bernhardkelm/punkt-strich/docs/animations/attention.png

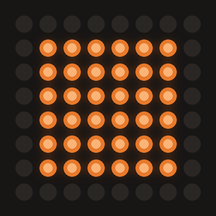
docs/animations/attention.png
