bernhardkelm/punkt-strich/docs/animations/compacting.png

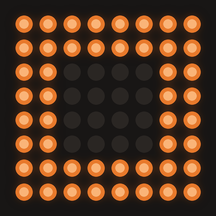
docs/animations/compacting.png
