bernhardkelm/punkt-strich/docs/animations/glitch.png

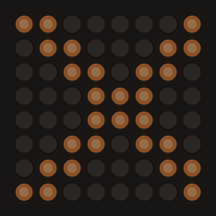
docs/animations/glitch.png
