bernhardkelm/punkt-strich/docs/animations/knight.png

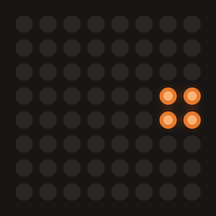
docs/animations/knight.png
