bernhardkelm/punkt-strich/docs/animations/life.png

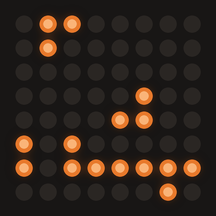
docs/animations/life.png
