bernhardkelm/punkt-strich/docs/animations/limit.png

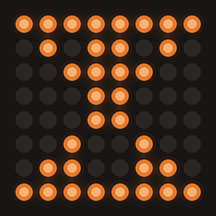
docs/animations/limit.png
