bernhardkelm/punkt-strich/docs/animations/loading.png

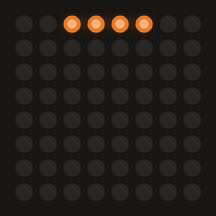
docs/animations/loading.png
