bernhardkelm/punkt-strich/docs/animations/pipes.png

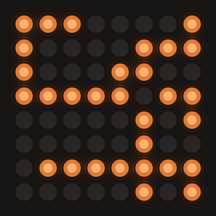
docs/animations/pipes.png
