bernhardkelm/punkt-strich/docs/animations/pong.png

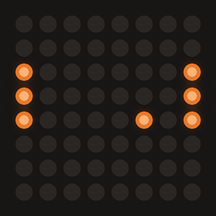
docs/animations/pong.png
