bernhardkelm/punkt-strich/docs/animations/rain.png

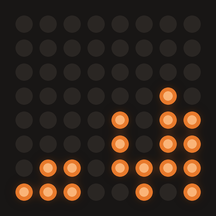
docs/animations/rain.png
