bernhardkelm/punkt-strich/docs/animations/scan.png

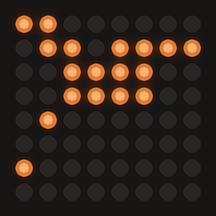
docs/animations/scan.png
