bernhardkelm/punkt-strich/docs/animations/terminal.png

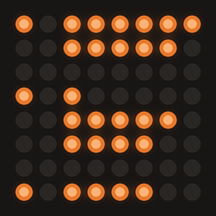
docs/animations/terminal.png
