bernhardkelm/punkt-strich/docs/blueprint/social-preview.png

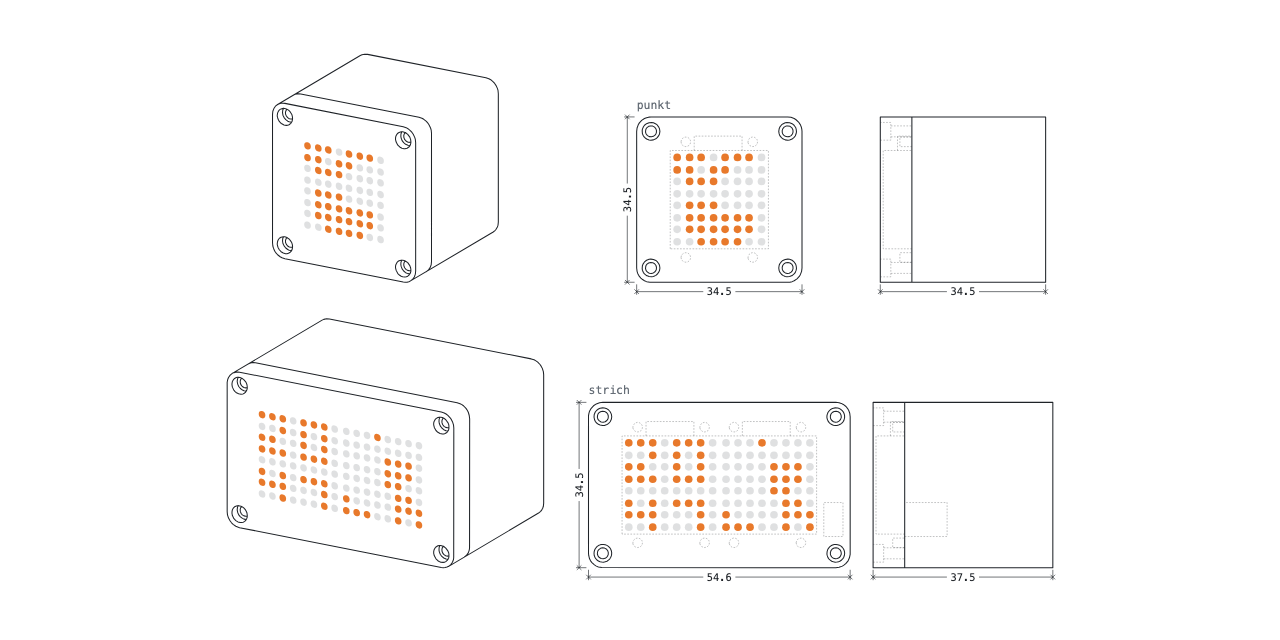
docs/blueprint/social-preview.png
