bernhardkelm/punkt-strich/hardware/punkt_case.3mf

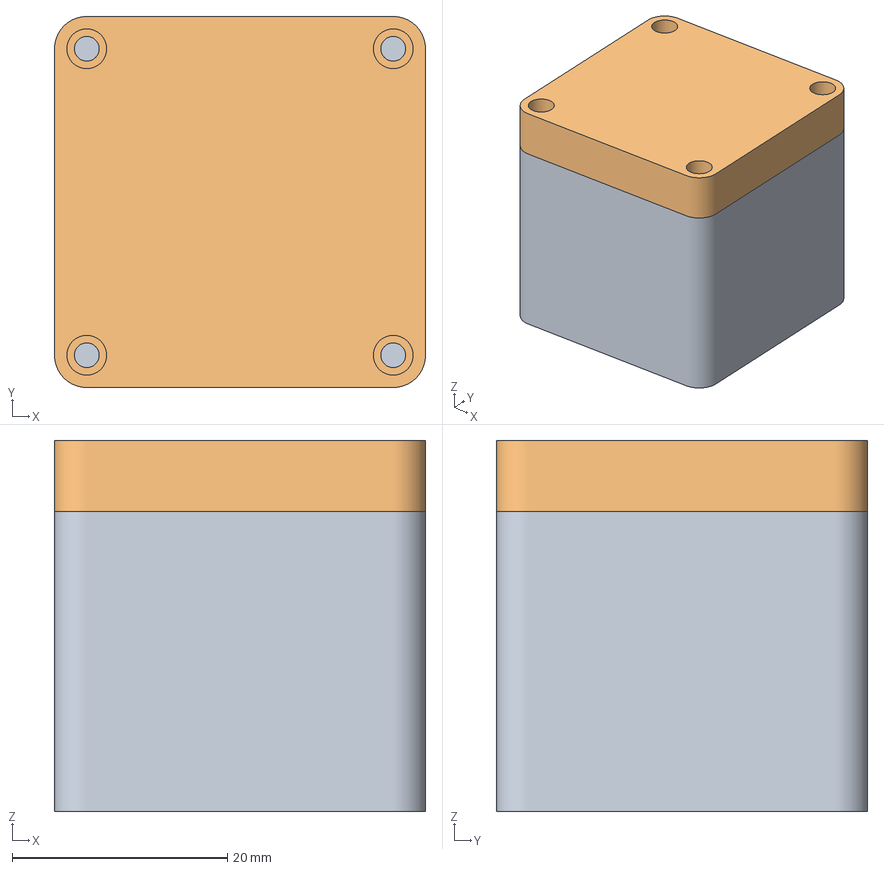
[picture p55: CAD file, 2026-10-19]
hardware/punkt_case.3mf
34.5 x 34.5 x 34.5 mm
Case
Screen
