bernhardkelm/punkt-strich/hardware/strich_case.3mf

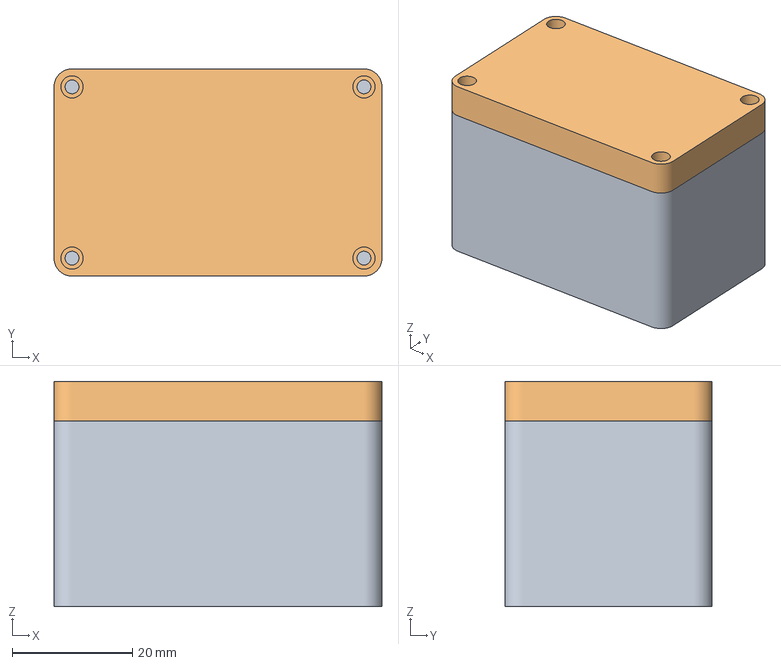
[picture p56: CAD file, 2026-10-19]
hardware/strich_case.3mf
54.6 x 34.5 x 37.5 mm
Strich case
Strich screen
