bernhardkelm/punkt-strich/hardware/esp_solder_jig.3mf

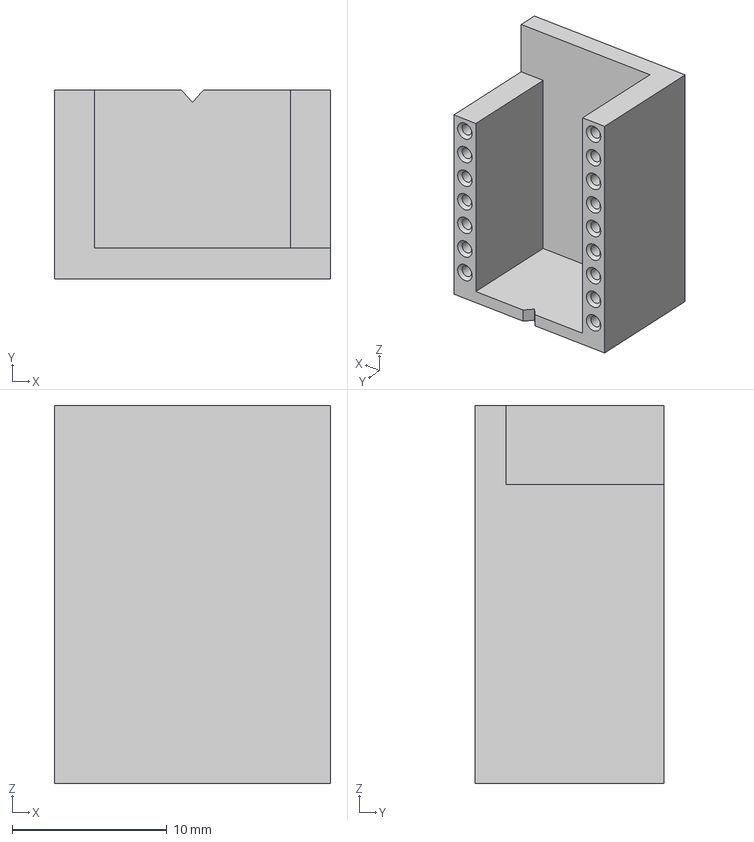
[picture p57: CAD file, 2026-10-19]
hardware/esp_solder_jig.3mf
17.8 x 12.2 x 24.4 mm
