bernhardkelm/punkt-strich/(commit log)

2026-10-19 Initial release
    [esp_solder_jig.3mf, punkt_case.3mf, strich_case.3mf]
2026-10-20 Changed brightness ownership due to a bug where brightness could jump during dimming times and touch interactions
    [Animation.h, Done.cpp, Done.h, Glitch.cpp, Glitch.h, Off.cpp, Off.h, State.cpp]
